BombVoyage/soft_elbow_orthosis/report/acknowledgements.tex

\chapter{Acknowledgements}
First I would like to thank Alexandre Kruszewski for his guidance during this project.
Many thanks to Antoine Dequidt for his insights on wearable robotics.
Thanks to Fabien Verbrugghe and Gilles Marguerite for lending me their technical expertise.
Special thanks to Clémence Muller for sewing the sensor system to the sock that I cut open.
Last but not least, big thanks to the DEFROST team for accepting my participation 
in this project.
