BombVoyage/soft_elbow_orthosis/report/title.tex

\begin{titlepage}
\topskip0pt
\vspace*{\fill}

\begin{center}
% Title
\Large \textbf {PDI Report}\\[0.7in]       

% Submitted by
\normalsize Submitted by \\[0.2in]
\textbf{David Kirov}\\
Final year student\\
at\\
Ecole Centrale de Lille\\

\vspace{.2in}
Under the guidance of\\[0.2in]
\textbf{Alexandre Kruszewski}\\
Professor at Ecole Centrale de Lille\\[0.5in]
\normalsize 2023-2024\\
\begin{figure}[htbp]
  \centering
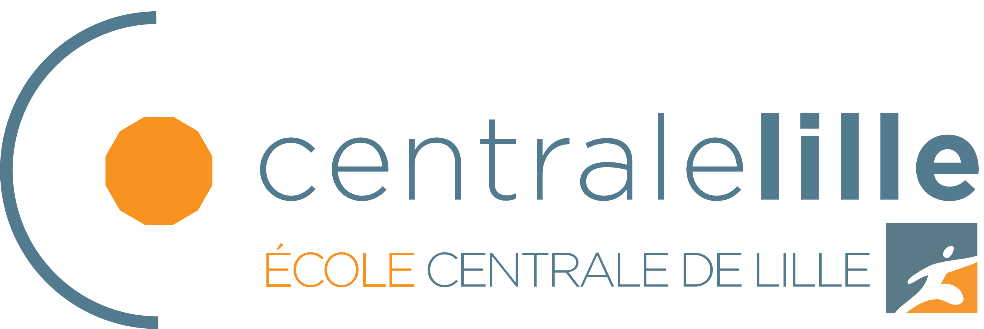
[picture p2: report/images/Centrale_Lille.png]
  
  \label{fig:centrale}
\end{figure}

\end{center}
\vspace*{\fill}
\end{titlepage}
