BombVoyage/soft_elbow_orthosis/images/back_view.jpg

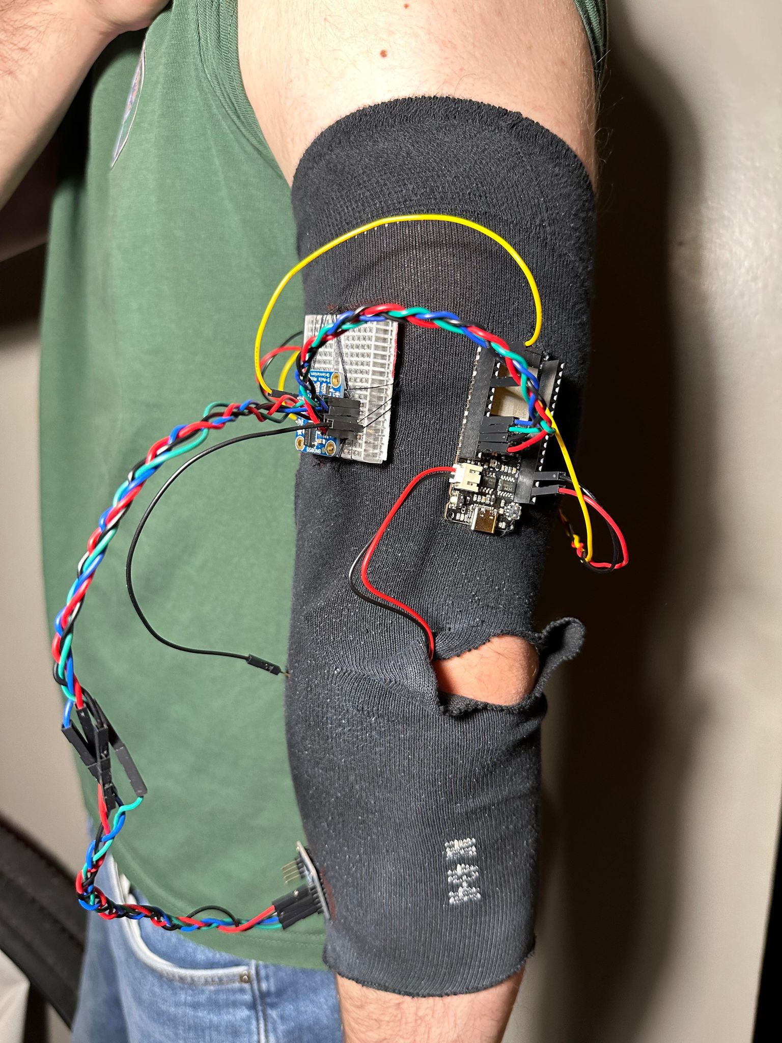
images/back_view.jpg
