BombVoyage/soft_elbow_orthosis/images/back_view.png

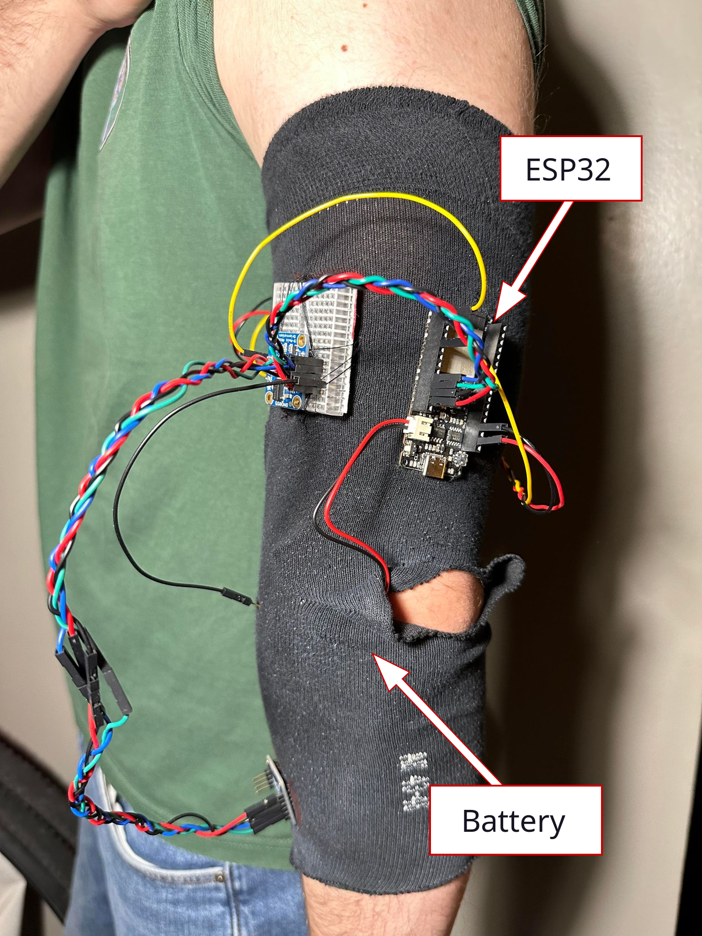
images/back_view.png
