BombVoyage/soft_elbow_orthosis/images/bno055_sensor.jpg

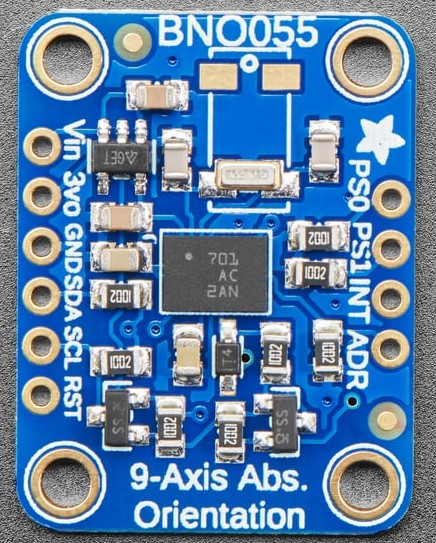
images/bno055_sensor.jpg
