BombVoyage/soft_elbow_orthosis/images/esp32.jpg

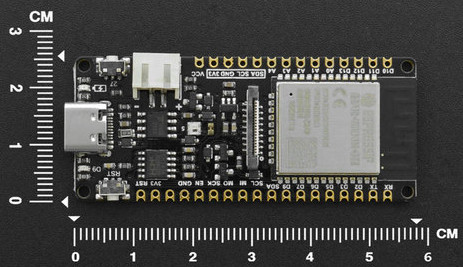
images/esp32.jpg
