BombVoyage/soft_elbow_orthosis/images/front_view.jpg

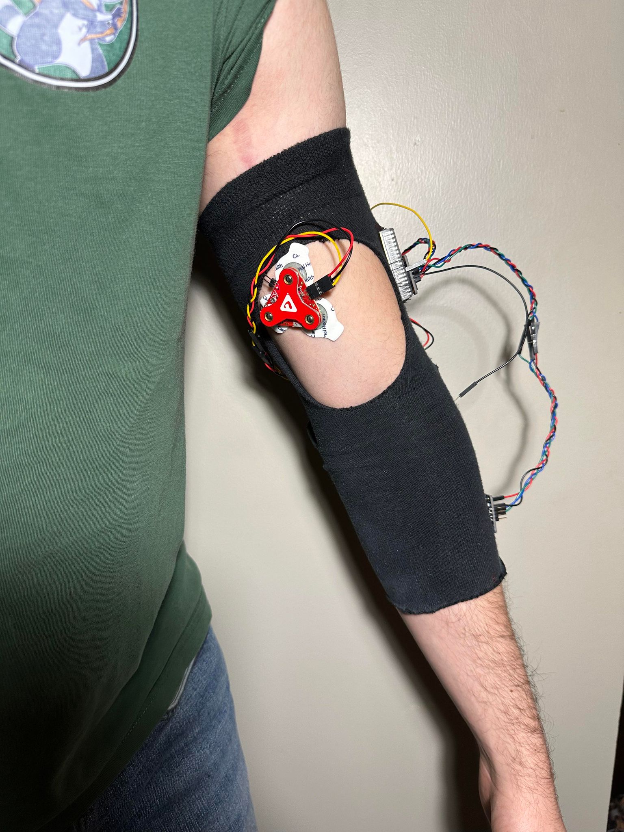
images/front_view.jpg
