BombVoyage/soft_elbow_orthosis/images/multi_open_vs_closed_too_heavy.png

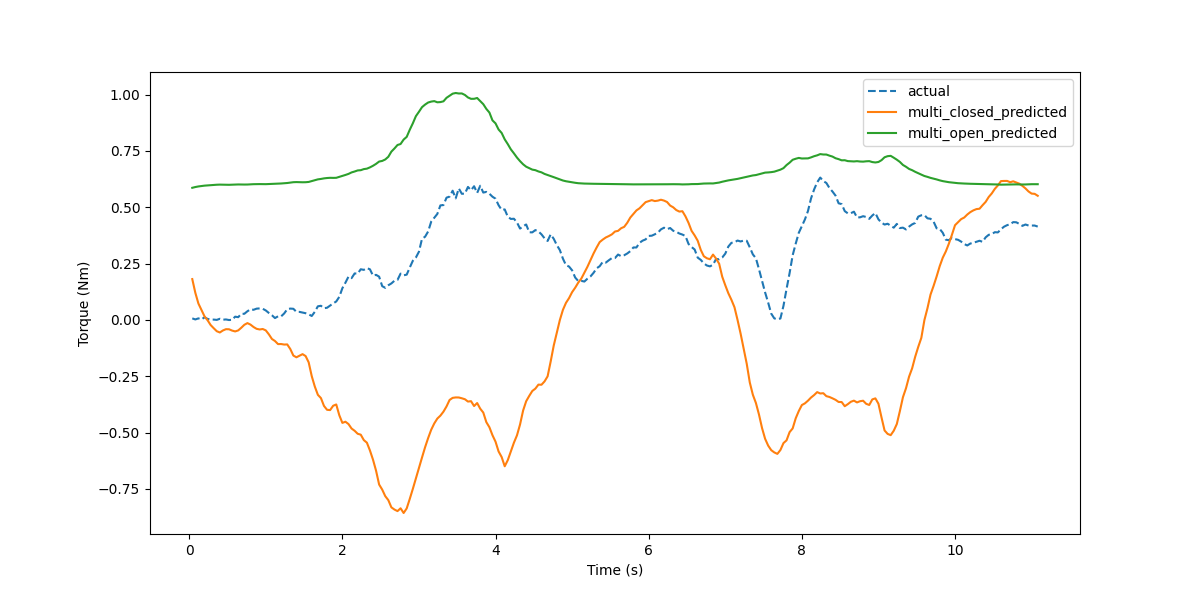
images/multi_open_vs_closed_too_heavy.png
