BombVoyage/soft_elbow_orthosis/images/passive_orthosis.jpg

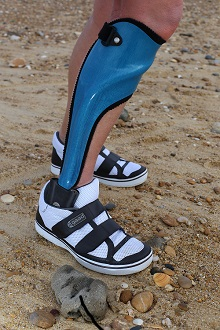
images/passive_orthosis.jpg
