BombVoyage/soft_elbow_orthosis/images/processed.png

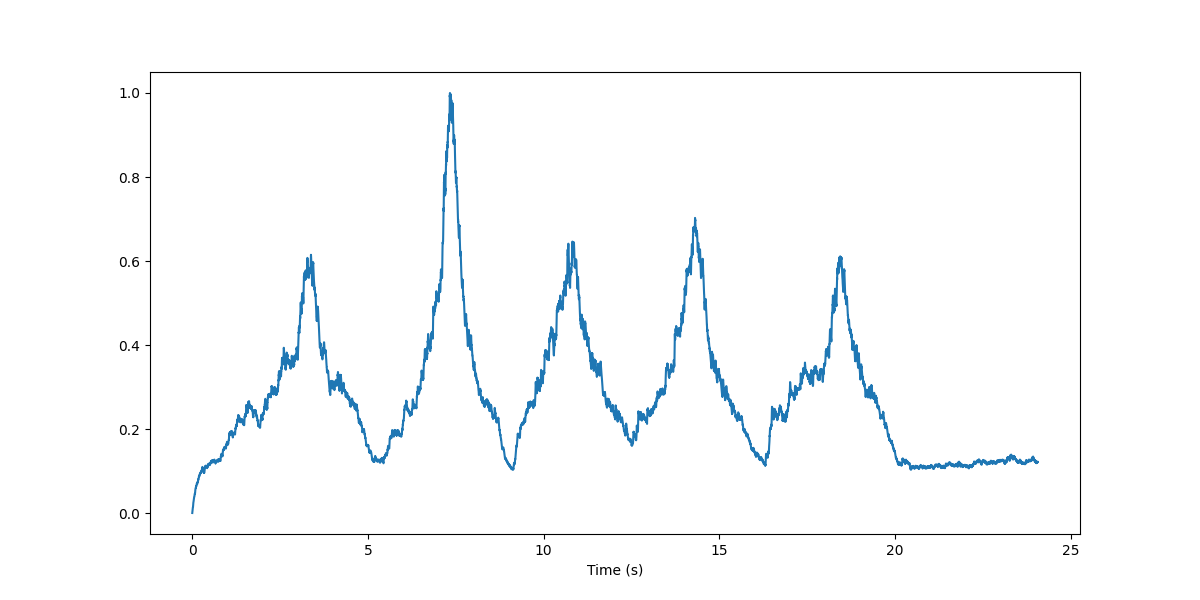
images/processed.png
