BombVoyage/soft_elbow_orthosis/images/processing.png

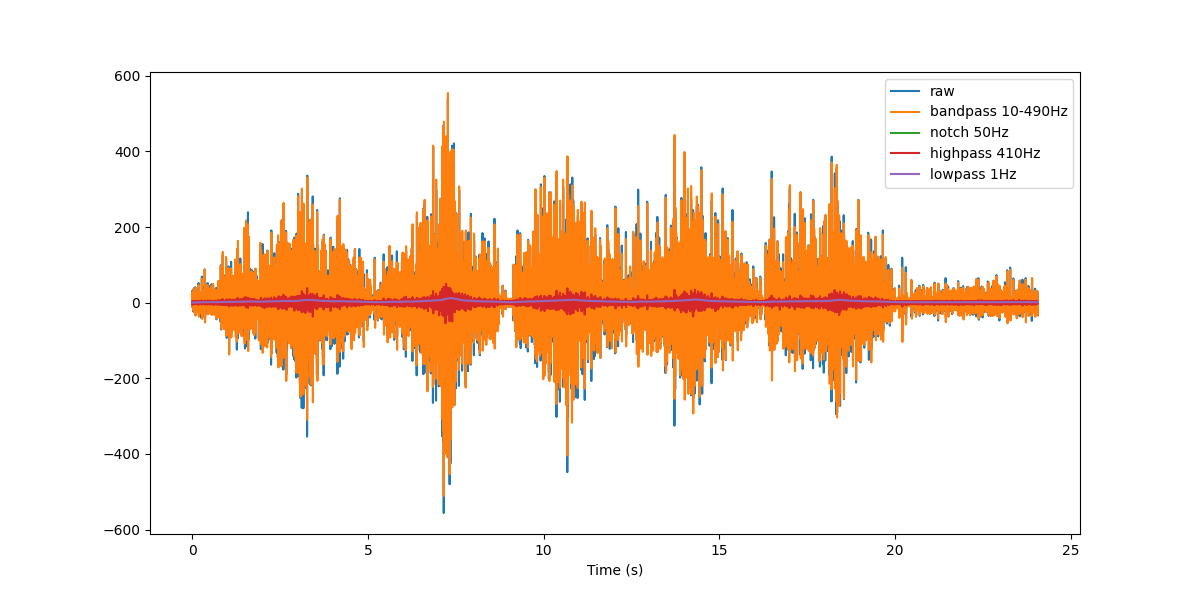
images/processing.png
