BombVoyage/soft_elbow_orthosis/images/torque_from_angle.png

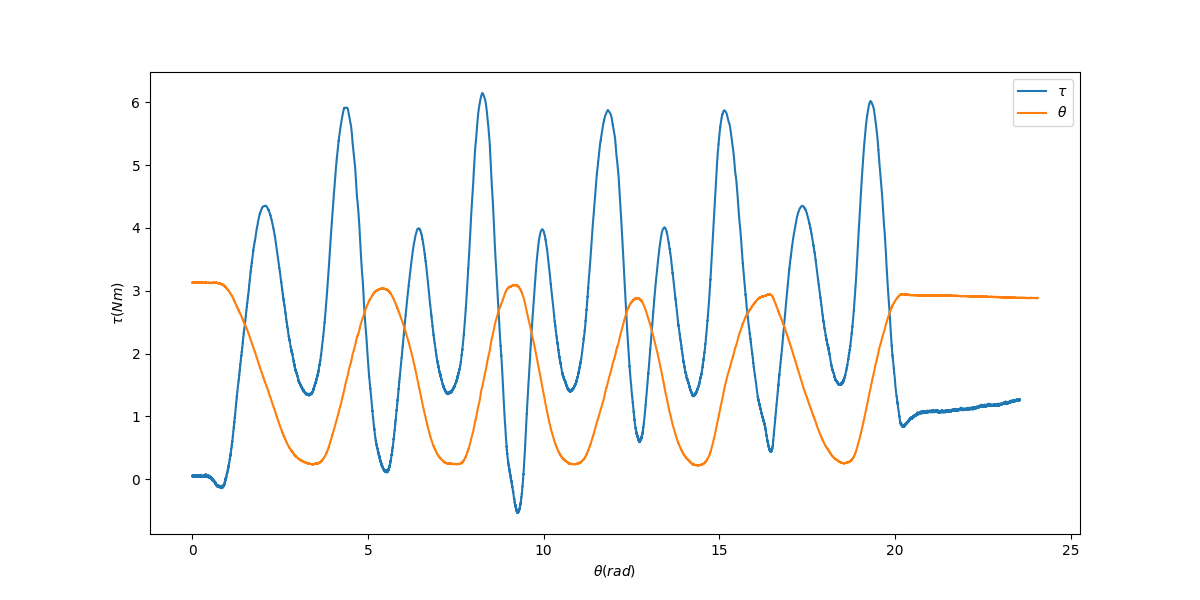
images/torque_from_angle.png
