BombVoyage/soft_elbow_orthosis/python/figures/david_no_load.png

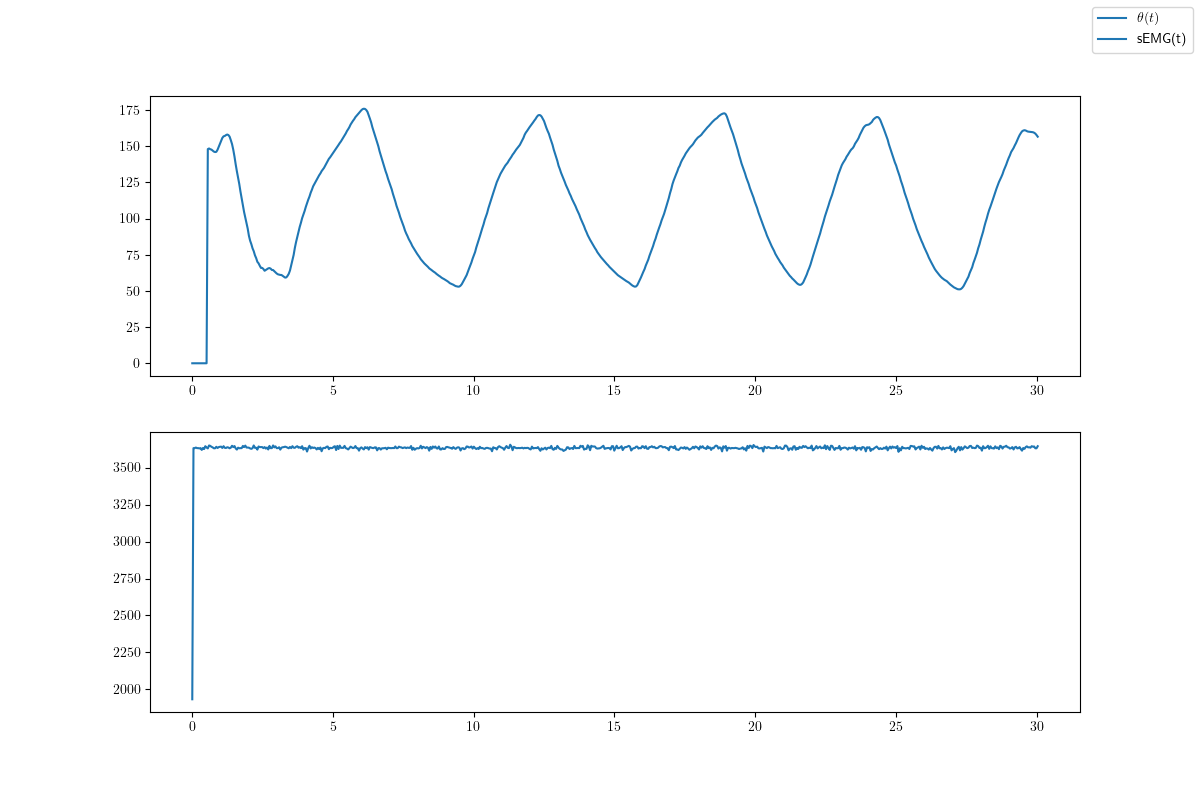
python/figures/david_no_load.png
