BombVoyage/soft_elbow_orthosis/images/setup.jpg

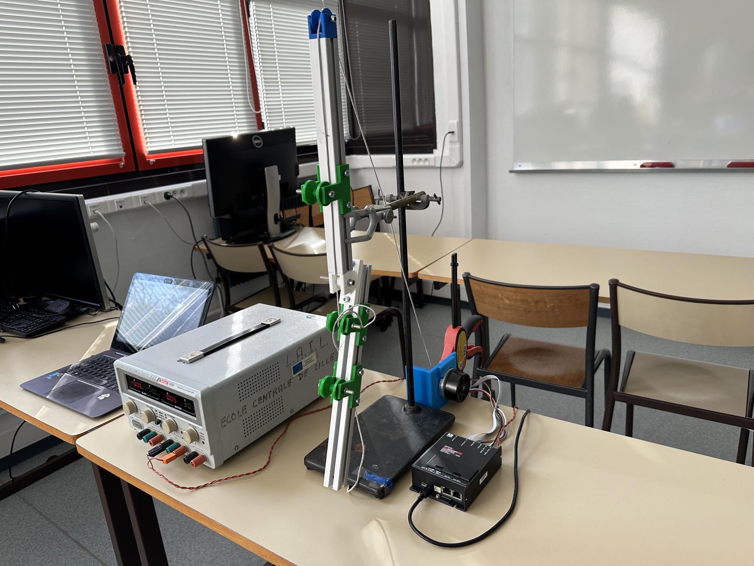
images/setup.jpg
