BombVoyage/soft_elbow_orthosis/data/test.csv

time | $\theta$ | sEMG | u
0.0001709461212158203 | 2.03 | 1266.0 | 0.0
0.0002727508544921875 | 2.03 | 1216.0 | 0.0
0.0003604888916015625 | 2.03 | 1209.0 | 2.8208874190520388
0.013473272323608398 | 2.03 | 1231.0 | 2.6953709233235092
0.016269207000732422 | 2.03 | 1322.0 | 2.455408787395754
0.018872499465942383 | 2.03 | 1290.0 | 2.5511350416385565
0.021424293518066406 | 2.03 | 1330.0 | 2.5882954816451558
0.024134159088134766 | 2.03 | 1275.0 | 2.672053653647918
0.027270793914794922 | 2.03 | 1223.0 | 2.868265125463054
0.029752492904663086 | 2.02 | 1215.0 | 2.8180209456585414
0.032224178314208984 | 2.02 | 1222.0 | 2.7278189987609123
0.03466677665710449 | 2.02 | 1235.0 | 2.683667498456045
0.03739500045776367 | 2.02 | 1221.0 | 2.7259965711122165
0.04017782211303711 | 2.02 | 1199.0 | 2.8011877236385394
0.042670488357543945 | 2.02 | 1182.0 | 2.8268033843338034
0.04514193534851074 | 2.02 | 1196.0 | 2.7637073551619165
0.04763627052307129 | 2.02 | 1239.0 | 2.631021116720069
0.05080747604370117 | 2.02 | 1205.0 | 2.7276017619550554
0.05329132080078125 | 2.02 | 1238.0 | 2.7134505937565376
0.05577969551086426 | 2.02 | 1163.0 | 2.84419072419636
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
