BombVoyage/soft_elbow_orthosis/python/figures/test2.png

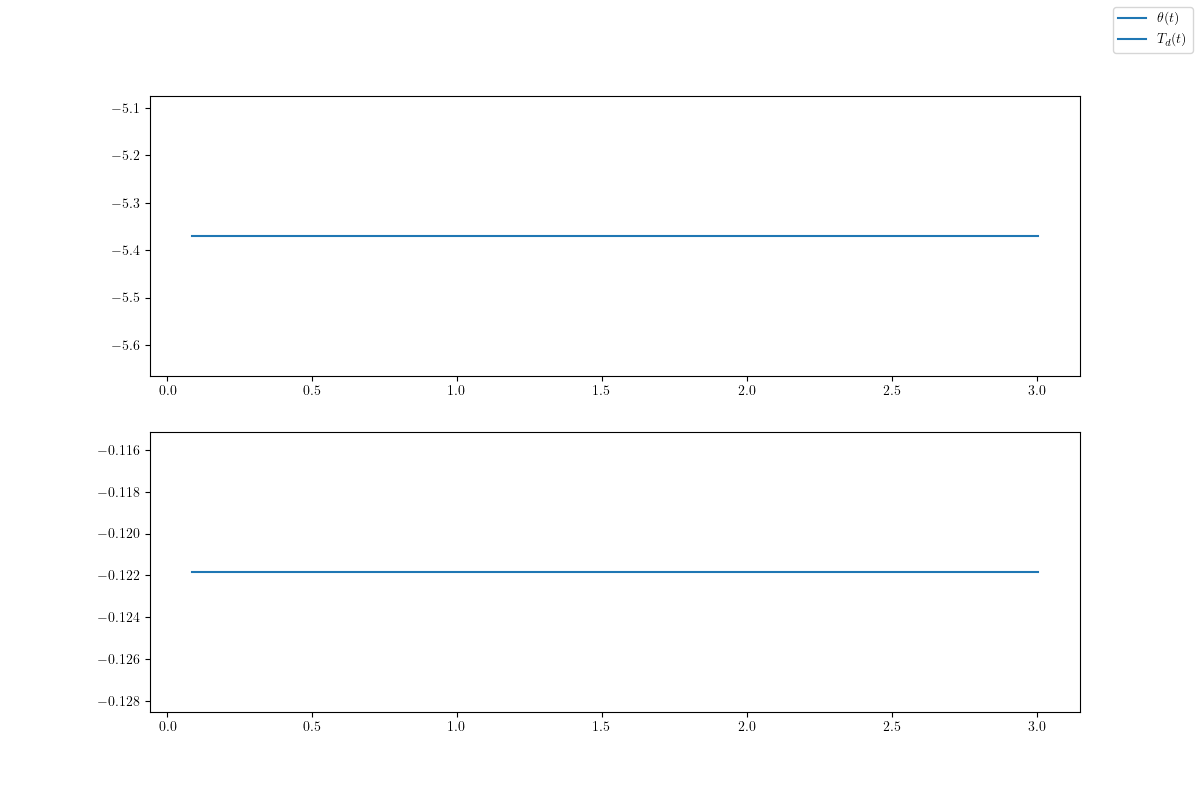
python/figures/test2.png
