BombVoyage/soft_elbow_orthosis/python/figures/test.png

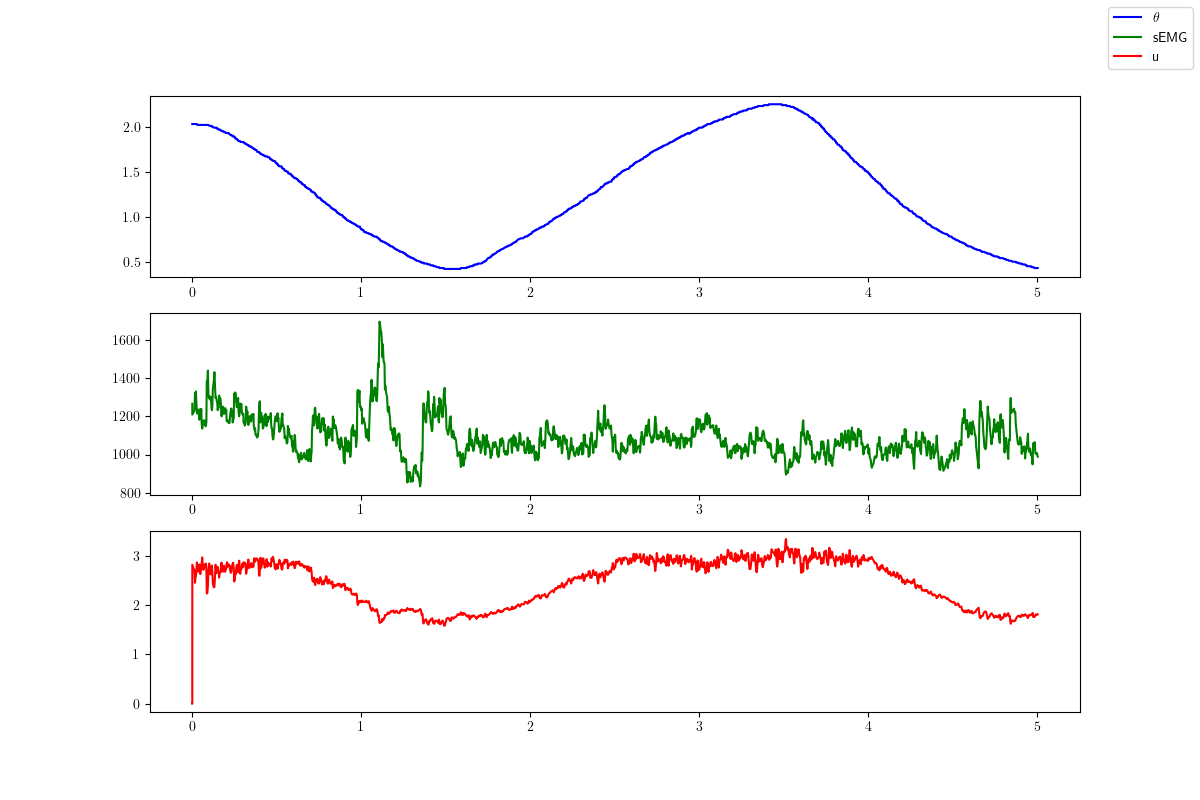
python/figures/test.png
